uboarddspic/04.-Webboard/Photo's/DSC02059.JPG

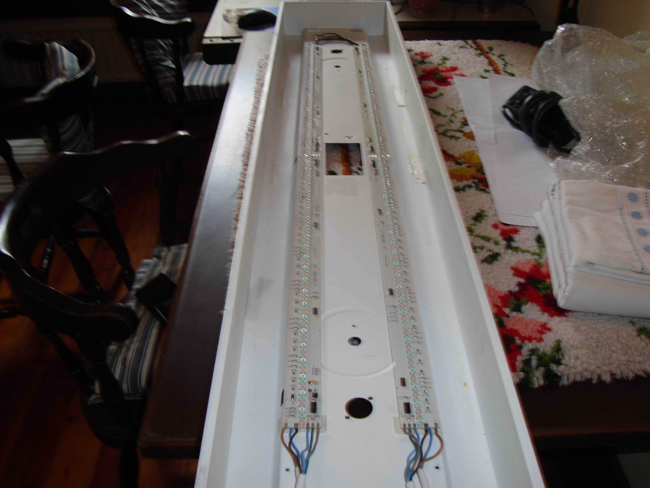
Photo's/DSC02059.JPG
