uboarddspic/04.-Webboard/Photo's/DSC02157.JPG

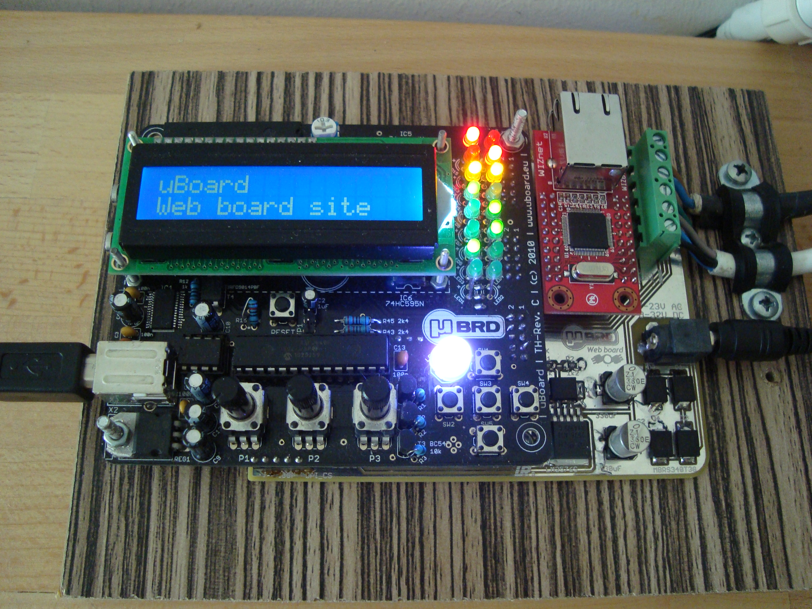
Photo's/DSC02157.JPG
