uboarddspic/04.-Webboard/Photo's/DSC02058.JPG

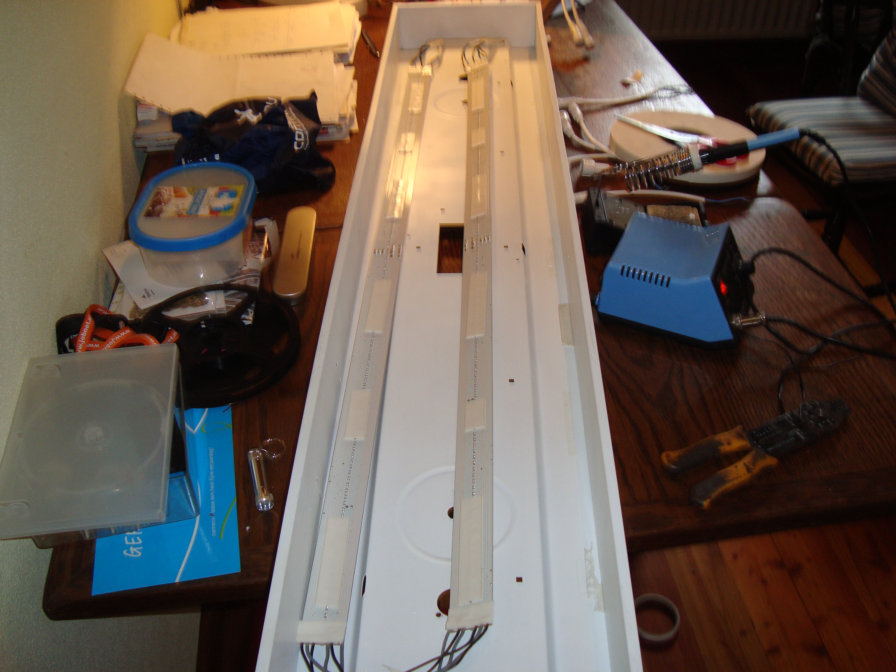
Photo's/DSC02058.JPG
