uboarddspic/04.-Webboard/Schematic/partlist-Web Board.xlsx

Build of materials Web Board
Components | Manufacturer Part No. | Supplier | Order code | Price | Quantity | Total
Ic's
Conv DC-DC Single Step Down 4V to 40V | LM2576-5.0WU | RS | 727-5021 | €3.82 | 1 | €3.82
Module Network (W5100 + RJ45) 2.54mm pin | WIZ811MJ | RS | 698-9160 | €25.14 | 1 | €25.14
Resistors & capacitors
Anti-Surge Resistor, 1206, 0.33W,1%,1K2 | ERJP08F1201V | RS | 721-9826 | €0.15 | 1 | €0.15
Anti-Surge Resistor, 1206, 0.33W,1%,2K | ERJP08F2001V | RS | 721-9844 | €0.15 | 1 | €0.15
CRG1206 SMT chip resistor,10K 0.25W | CRG1206F10K | RS | 223-2394 | €0.04 | 1 | €0.04
SMT 1206 Z5U ceramic capacitor,0.1uF 50V | C1206C104M5UAC | RS | 264-4191 | €0.03 | 1 | €0.03
Al cap CW series SMT 25V 330uF | UCW1E331MNL1GS | RS | 715-1701 | €0.36 | 4 | €1.43
Various
SMD shielded power choke, 220uH, 430 mA | 744778222/LF | RS | 617-1489 | €2.00 | 1 | €2.00
Diode,barrier,Schottky,STPS340S | STPS340S | RS | 486-0266 | €0.70 | 5 | €3.51
M20 SOCKET, SIL, VERTICAL, 5w,2.54MM | M20-7820546 | RS | 681-6823 | €1.21 | 1 | €1.21
TERMINAL BLOCK, PCB, 2WAY | 20.700M/2 | Farnell | 9633324 | €0.72 | 3 | €2.16
M20 SOCKET, SIL, VERTICAL, 5w,2.54MM | M20-7820546 | RS | 681-6823 | €1.21 | 1 | €1.21
M20 SOCKET, DIL, VERTICAL, 5w,2.54MM | M20-7830546 | RS | 681-6845 | €2.06 | 2 | €4.13
SWITCHCRAFT - RAPC712X - JACK SOCKET, DC | RAPC712X | Farnell | 1608726 | €1.40 | 1 | €1.40
http://www.velleman.eu/distributor/products/view/?id=49777
Total |  |  |  |  |  | €46.38
