uboarddspic/04.-Webboard/Schematic/Schematic-Webboard.pdf

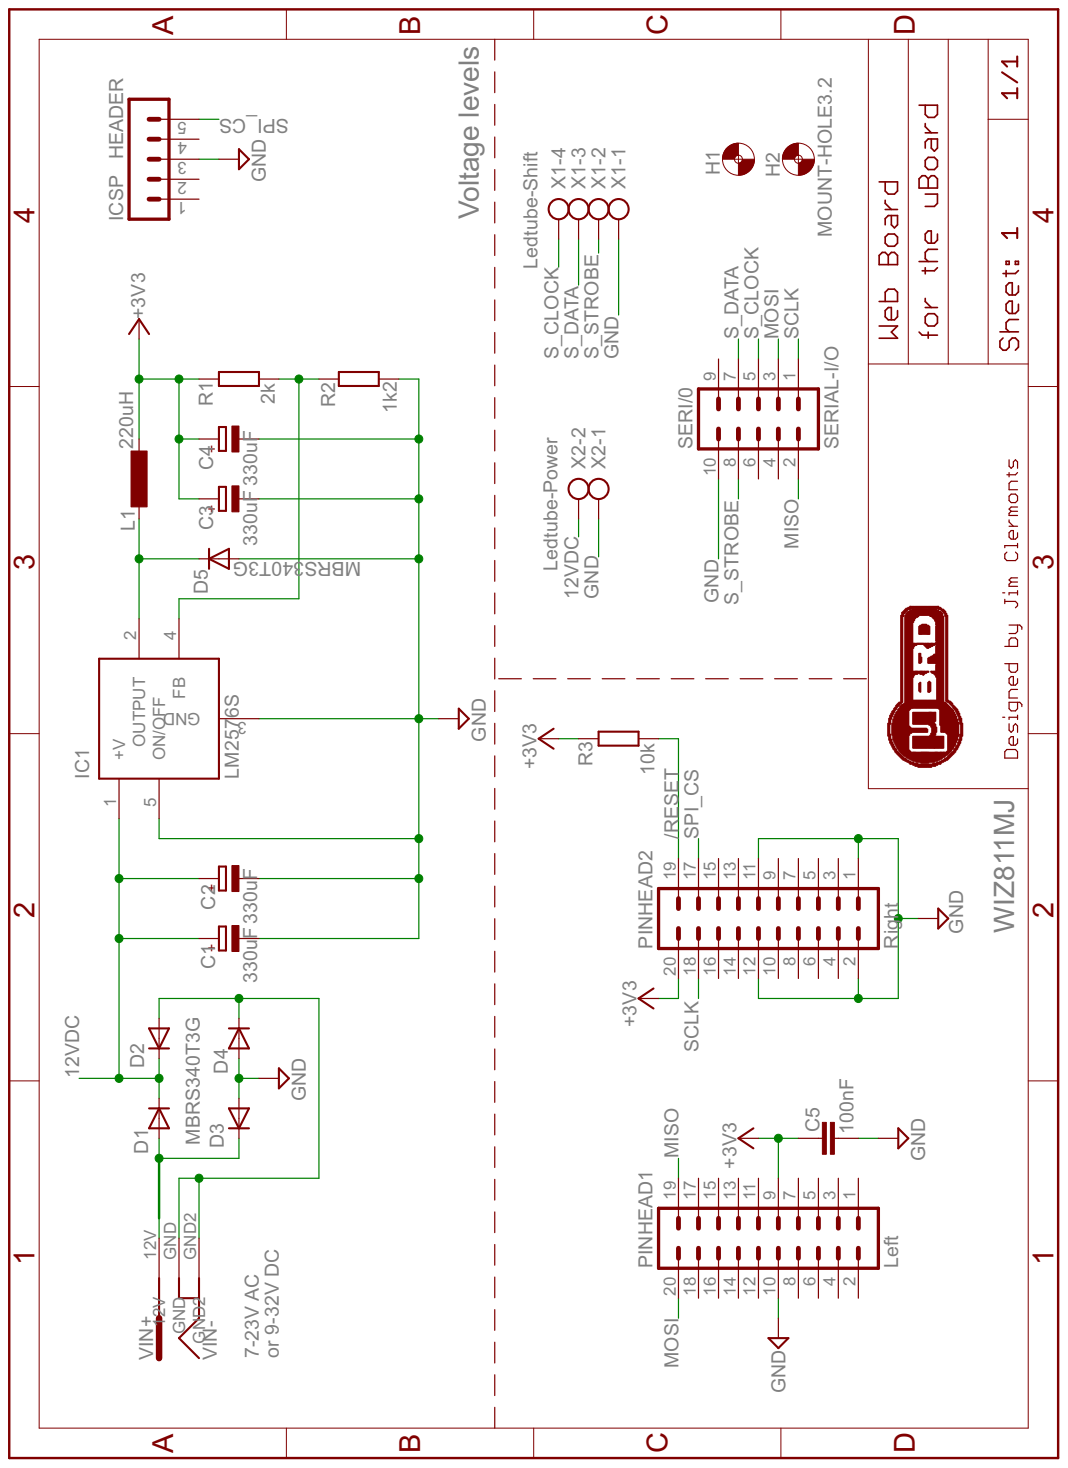
[picture p4: page 1]

++ ABCD 1 2 3 4 ABCD 1 2 3 4 ++ 7-23V AC or 9-32V DC Voltage levels WIZ811MJ C5 R3 C3 C2 531 642 97 810 111315 121416 1719 1820 PINHEAD2 531 642 97 810 111315 121416 1719 1820 PINHEAD1 531 642 97 810 SERI/0 12345 ICSP DNG 3 +V 1 ON/OFF 5 FB 4 OUTPUT 2 IC1 D5 R1 R2 C4 D1 D2 D3 D4 C1 L1 X1-1 X1-2 X1-3 X1-4 X2-1 X2-2 H1 H2 12V 12V GND GND GND2 GND2 MOSI MOSI MISO MISO GND GND GND /RESET SCLK SCLK SPI_CS SC_I PS S_STROBE S_STROBE S_CLOCK S_CLOCK S_DATA S_DATA VIN- VIN+ 12VDC 12VDC 100nF 10k 330uF 330uF GND GND GND +3V3 +3V3 +3V3 Right Left GND SERIAL-I/O HEADER GND LM2576S G3T043SRB M 2k 1k2 330uF MBRS340T3G GND 330uF 220uH Ledtube-Shift Ledtube-Power MOUNT-HOLE3.2 +3V3
