uboarddspic/04.-Webboard/Schematic/PCB-Top-Webboard.pdf

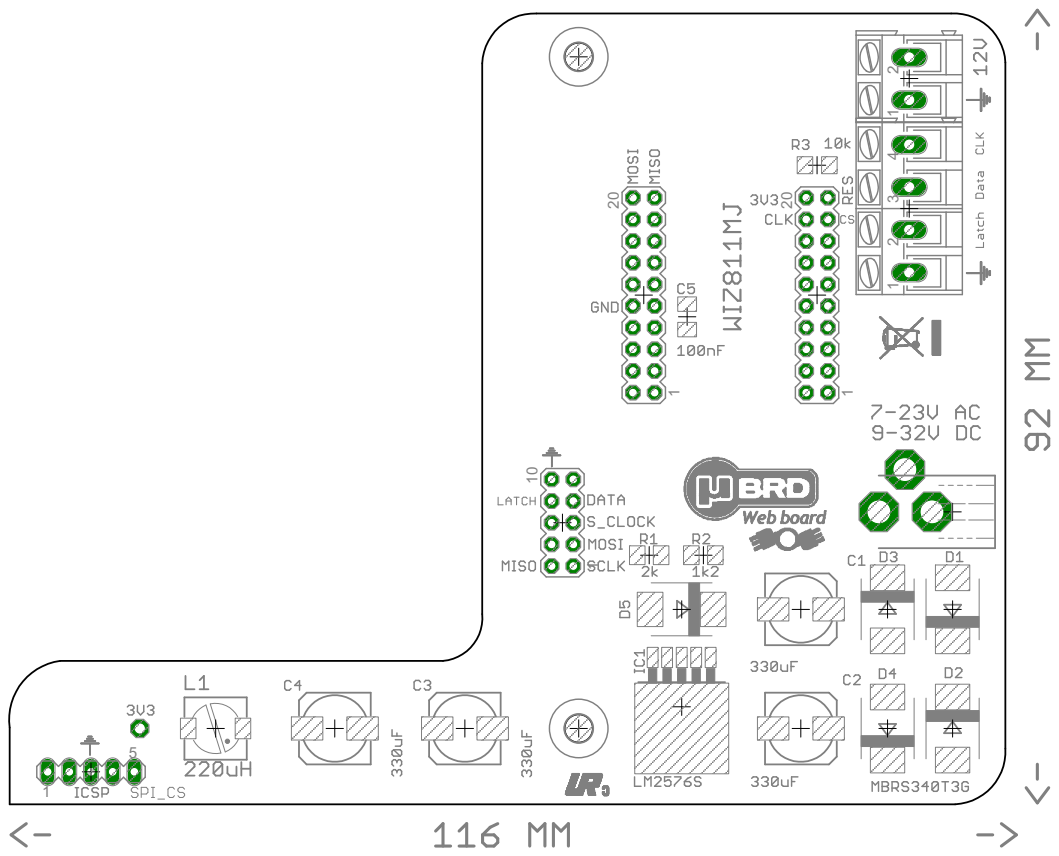
[picture p5: page 1]
