uboarddspic/04.-Webboard/Code/01. Web board ping/W5100.h

/*
 * Prototype definitions for W5100
 */
#ifndef	__W5100_h
#define	__W5100_h

#define SPI_CS	LATBbits.LATB11
#define T_SPI_CS  TRISBbits.TRISB11=0;

#define WRITE_OPCODE 0xF0
#define READ_OPCODE 0x0F
#define GAR 0x0001
#define MR 0x0000
#define GAR  0x0001   // Gateway Address: 0x0001 to 0x0004
#define SUBR 0x0005   // Subnet mask Address: 0x0005 to 0x0008
#define SAR  0x0009   // Source Hardware Address (MAC): 0x0009 to 0x000E
#define SIPR 0x000F   // Source IP Address: 0x000F to 0x0012
#define RMSR 0x001A   // RX Memory Size Register
#define TMSR 0x001B   // TX Memory Size Register

#define TX_BUF_MASK      0x07FF   // Tx 2K Buffer Mask:
#define RX_BUF_MASK      0x07FF   // Rx 2K Buffer Mask:
#define NET_MEMALLOC     0x05     // Use 2K of Tx/Rx Buffer

#define S0_MR	   0x0400      // Socket 0: Mode Register Address
#define S0_CR	   0x0401      // Socket 0: Command Register Address
#define S0_IR	   0x0402      // Socket 0: Interrupt Register Address
#define S0_SR	   0x0403      // Socket 0: Status Register Address
#define S0_PORT    0x0404      // Socket 0: Source Port: 0x0404 to 0x0405
#define SO_TX_FSR  0x0420      // Socket 0: Tx Free Size Register: 0x0420 to 0x0421
#define S0_TX_RD   0x0422      // Socket 0: Tx Read Pointer Register: 0x0422 to 0x0423
#define S0_TX_WR   0x0424      // Socket 0: Tx Write Pointer Register: 0x0424 to 0x0425
#define S0_RX_RSR  0x0426      // Socket 0: Rx Received Size Pointer Register: 0x0425 to 0x0427
#define S0_RX_RD   0x0428      // Socket 0: Rx Read Pointer: 0x0428 to 0x0429
#define TXBUFADDR  0x4000      // W5100 Send Buffer Base Address
#define RXBUFADDR  0x6000      // W5100 Read Buffer Base Address
// S0_MR values
#define MR_CLOSE	  0x00    // Unused socket
#define MR_TCP		  0x01    // TCP
#define MR_UDP		  0x02    // UDP
#define MR_IPRAW	  0x03	  // IP LAYER RAW SOCK
#define MR_MACRAW	  0x04	  // MAC LAYER RAW SOCK
#define MR_PPPOE	  0x05	  // PPPoE
#define MR_ND		  0x20	  // No Delayed Ack(TCP) flag
#define MR_MULTI	  0x80	  // support multicating
// S0_CR values
#define CR_OPEN          0x01	  // Initialize or open socket
#define CR_LISTEN        0x02	  // Wait connection request in tcp mode(Server mode)
#define CR_CONNECT       0x04	  // Send connection request in tcp mode(Client mode)
#define CR_DISCON        0x08	  // Send closing reqeuset in tcp mode
#define CR_CLOSE         0x10	  // Close socket
#define CR_SEND          0x20	  // Update Tx memory pointer and send data
#define CR_SEND_MAC      0x21	  // Send data with MAC address, so without ARP process
#define CR_SEND_KEEP     0x22	  // Send keep alive message
#define CR_RECV          0x40	  // Update Rx memory buffer pointer and receive data
// S0_SR values
#define SOCK_CLOSED      0x00     // Closed
#define SOCK_INIT        0x13	  // Init state
#define SOCK_LISTEN      0x14	  // Listen state
#define SOCK_SYNSENT     0x15	  // Connection state
#define SOCK_SYNRECV     0x16	  // Connection state
#define SOCK_ESTABLISHED 0x17	  // Success to connect
#define SOCK_FIN_WAIT    0x18	  // Closing state
#define SOCK_CLOSING     0x1A	  // Closing state
#define SOCK_TIME_WAIT	 0x1B	  // Closing state
#define SOCK_CLOSE_WAIT  0x1C	  // Closing state
#define SOCK_LAST_ACK    0x1D	  // Closing state
#define SOCK_UDP         0x22	  // UDP socket
#define SOCK_IPRAW       0x32	  // IP raw mode socket
#define SOCK_MACRAW      0x42	  // MAC raw mode socket
#define SOCK_PPPOE       0x5F	  // PPPOE socket
#define TX_BUF_MASK      0x07FF   // Tx 2K Buffer Mask:
#define RX_BUF_MASK      0x07FF   // Rx 2K Buffer Mask:
#define MEMALLOC     0x05     // Use 2K of Tx/Rx Buffer
#define TCP_PORT         80       // TCP/IP Port

void Init_pin_SPI(void);
void Init_SPI(void);
void W5100_Init(unsigned char* gtw_addr,unsigned char* mac_addr,unsigned char* sub_mask,unsigned char* ip_addr);
void SPI_Write(unsigned int addr, unsigned char data);
unsigned char SPI_Read(unsigned int addr);

#endif	//__uBRD_h
